Muhammad-Arsalan03/Boom-sprayer-constant-presssure-Flow-control-using-/Flow diagram.pptx

Computer

Arduino

Over flow valve

Pressure
Gauge

PWM signal

PWM signal

Excessive psi

pump

Flow
meter

Solenoid

nozzle

60 psi

60 psi

Water tank

Collector

Flow diagram of Over Flow valve/ Pressure relief valve/
Pressure safety valve

## Slide 2

Computer

Arduino

Pressure
Sensor

PWM signal

Excessive psi

Solenoid

pump

Flow
meter

Solenoid

nozzle

60 psi

60 psi

Water tank

Collector

## Slide 3

Computer

Arduino

Pressure
Gauge

PWM signal

Pressure
regulator

pump

100 psi

60 psi

Flow
meter

Solenoid

nozzle

Water tank

Collector

Flow diagram of Pressure regulating/Pressure reducing valve

## Over flow valve/ Pressure relief / Pressure safety valve

- https://www.youtube.com/watch?v=bvp7Zqls7Fw, animation and working.
- https://www.youtube.com/watch?v=uWg_lySYjU8, testing and changing setting pressure of overflow/ pressure relief valve

## Pressure reducing/ regulating valve

- https://www.youtube.com/watch?v=J53xqsygX-g , working and adjusting desired pressure in the system.
- https://www.youtube.com/watch?v=t73xZ-tpbAc, pressure reducing valve installation in home for reducing the pressure, supplied from the main line to the home , to prevent home piping system.
- https://www.youtube.com/watch?v=gA8zPfRUnvM, animation of pressure reducing valve working and adjusting pressure.

## Alibaba pressure relief valve.

- https://www.alibaba.com/product-detail/Good-quality-brass-pressure-relief-boiler_60690213760.html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
- https://www.alibaba.com/product-detail/1-1-4-Inch-Lead-Free_60811948391.html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
- https://www.alibaba.com/product-detail/Good-quality-brass-pressure-relief-boiler_60690213760.html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
- https://www.alibaba.com/product-detail/Brass-Pressure-Relief-Valve-for-Spraying_50013574528.html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

## Alibaba pressure regulating valve.

- https://www.alibaba.com/product-detail/Lead-free-Water-Reducer-for-RV_60531364523.html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
- https://www.alibaba.com/product-detail/Stainless-steel-adjustable-high-pressure-regulators_60808136731.html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
- https://www.alibaba.com/product-detail/Lead-free-Water-rv-reducing-valve_62014761745.html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
- https://www.alibaba.com/product-detail/PN16-DN15-1-2-2-Brass_60629794735.html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

## Sprayer plumbing with positive displacement pump and pressure relief or regulating valve.

- https://www.youtube.com/watch?v=ChEjRF79S-o
- https://www.youtube.com/watch?v=QIitM4zcuKQ
- https://www.youtube.com/watch?v=7lYkcjBMUgw
- https://www.youtube.com/watch?v=_cEVM6ak7Gk

## Slide 9

Computer

Arduino

Pressure
Gauge

PWM signal

Solenoid

pump

100 psi

60 psi

Flow
meter

Solenoid

nozzle

Water tank

Collector

## Slide 10

Desired
Flow rate

PID

ARDUINO

PWM

Nozzle solenoid

Actual Flowrate

Flow
Meter

## Slide 11

Computer

Arduino

Pressure
Gauge

PWM signal

Bypass line

pump

Solenoid

Flow
meter

Solenoid

nozzle

Water tank

Collector
