Muhammad-Arsalan03/Boom-sprayer-constant-presssure-Flow-control-using-/Flow diagram1.jpg

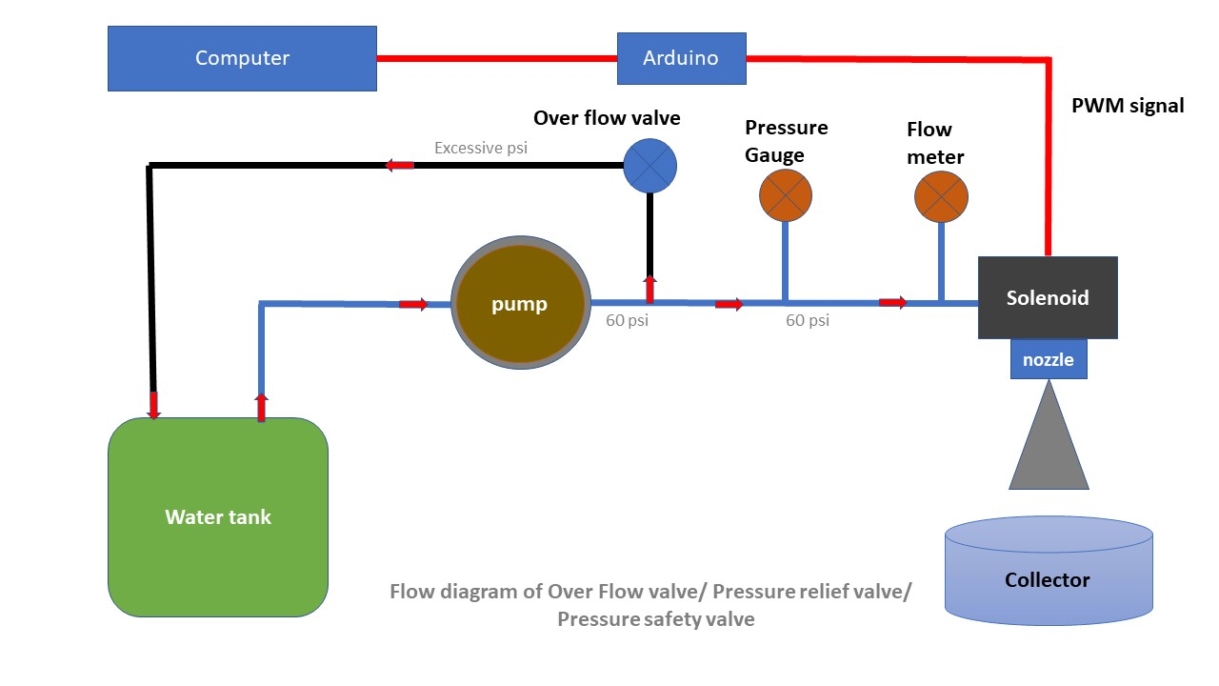
Flow diagram1.jpg
