Muhammad-Arsalan03/Boom-sprayer-constant-presssure-Flow-control-using-/Flow diagram2.jpg

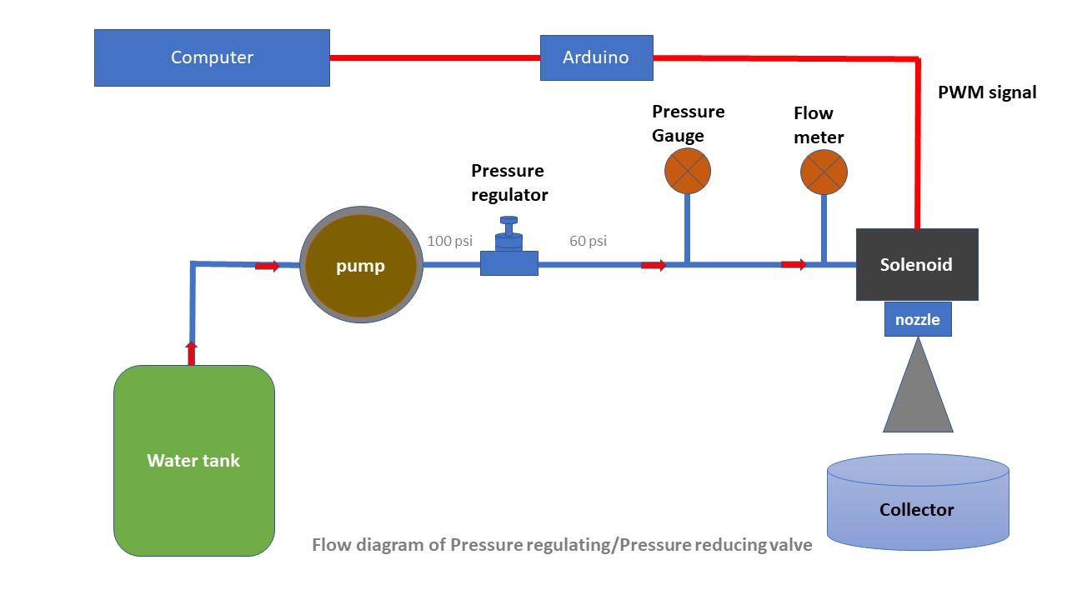
Flow diagram2.jpg
