Muhammad-Arsalan03/Boom-sprayer-constant-presssure-Flow-control-using-/pump_PWM.ino

int pot=A0;
int pump=10;

//flow sensor 
byte statusLed    = 13;

byte sensorInterrupt = 0;  // 0 = digital pin 2
byte sensorPin       = 2;

// The hall-effect flow sensor outputs approximately 4.5 pulses per second per
// litre/minute of flow.
float calibrationFactor =7;

volatile byte pulseCount;  

float flowRate;
unsigned int flowMilliLitres;
unsigned long totalMilliLitres;

unsigned long oldTime;
//---------

void setup() {
  //Flow sensor setup
    // Initialize a serial connection for reporting values to the host
  Serial.begin(9600);
   
  // Set up the status LED line as an output
  pinMode(statusLed, OUTPUT);
  digitalWrite(statusLed, HIGH);  // We have an active-low LED attached
  
  pinMode(sensorPin, INPUT);
  digitalWrite(sensorPin, HIGH);

  pulseCount        = 0;
  flowRate          = 0.0;
  flowMilliLitres   = 0;
  totalMilliLitres  = 0;
  oldTime           = 0;

  // The Hall-effect sensor is connected to pin 2 which uses interrupt 0.
  // Configured to trigger on a FALLING state change (transition from HIGH
  // state to LOW state)
  attachInterrupt(sensorInterrupt, pulseCounter, FALLING);
  /////------------
  
  // put your setup code here, to run once:
  Serial.println("Date & Time, DutyCycle,flowMilliLitres");  
Serial.begin(9600);
pinMode(pump,OUTPUT);
pinMode(pot,INPUT);
}

void loop() {
  // put your main code here, to run repeatedly:
//you can change the frequency by changing the ON/OFF time.
// total time =2 seconds, frequency =1/2=0.5 Hz
// duty cycle here is 50%
//delay time HIGH/total time=desired duty cycle

 if((millis() - oldTime) > 1000)    // Only process counters once per second
  { 
    // Disable the interrupt while calculating flow rate and sending the value to
    // the host
    detachInterrupt(sensorInterrupt);
        
    // Because this loop may not complete in exactly 1 second intervals we calculate
    // the number of milliseconds that have passed since the last execution and use
    // that to scale the output. We also apply the calibrationFactor to scale the output
    // based on the number of pulses per second per units of measure (litres/minute in
    // this case) coming from the sensor.
    flowRate = ((1000.0 / (millis() - oldTime)) * pulseCount) / calibrationFactor;
    
    // Note the time this processing pass was executed. Note that because we've
    // disabled interrupts the millis() function won't actually be incrementing right
    // at this point, but it will still return the value it was set to just before
    // interrupts went away.
    oldTime = millis();
    
    // Divide the flow rate in litres/minute by 60 to determine how many litres have
    // passed through the sensor in this 1 second interval, then multiply by 1000 to
    // convert to millilitres.
    flowMilliLitres = (flowRate) * 1000;
    
    // Add the millilitres passed in this second to the cumulative total
    totalMilliLitres += flowMilliLitres;
      
    unsigned int frac;
    
    // Print the flow rate for this second in litres / minute
   // Serial.print("Flow rate: ");
    //Serial.print(int(flowRate));  // Print the integer part of the variable
    //Serial.print(".");             // Print the decimal point
    // Determine the fractional part. The 10 multiplier gives us 1 decimal place.
   //frac = (flowRate - int(flowRate)) * 10;
   // Serial.print(frac, DEC) ;      // Print the fractional part of the variable
    //Serial.println("L/min");
    // Print the number of litres flowed in this second
    //Serial.print("  Current Liquid Flowing: ");             // Output separator
    //Serial.print(flowMilliLitres);
    //Serial.print("mL/min");

    // Print the cumulative total of litres flowed since starting
    //Serial.print("  Output Liquid Quantity: ");             // Output separator
   //Serial.print(totalMilliLitres);
   //Serial.println("mL"); 

    // Reset the pulse counter so we can start incrementing again
    pulseCount = 0;
    
    // Enable the interrupt again now that we've finished sending output
    attachInterrupt(sensorInterrupt, pulseCounter, FALLING);
  }
  float val=analogRead(A0);
float dutyCycle=map(val,0,1023,0,100);
Serial.println(dutyCycle);
Serial.print("DutyCycle= "); Serial.println(dutyCycle);
//int dutyCycle=60;
  float frequency=10;
float  t=(1/frequency)*1000; 
 // float dutyCycle=pwm;
float  TH=t*dutyCycle/100;
  float TL=t-TH;
  // Serial.print("TH= "); Serial.println(TH); Serial.print("TL= "); Serial.println(TL);
 digitalWrite(pump,HIGH);
  delay(TH);
 digitalWrite(pump,LOW);
  delay(TL);

// Serial.print(",");
//Serial.print(dutyCycle);
//Serial.print(",");
//Serial.println(flowMilliLitres);
  
}
void pulseCounter()
{
  // Increment the pulse counter
  pulseCount++;
}
